CPSCourse-TUM-HN/CPS-LabyrinTUM/calibration/live_roi_source.png

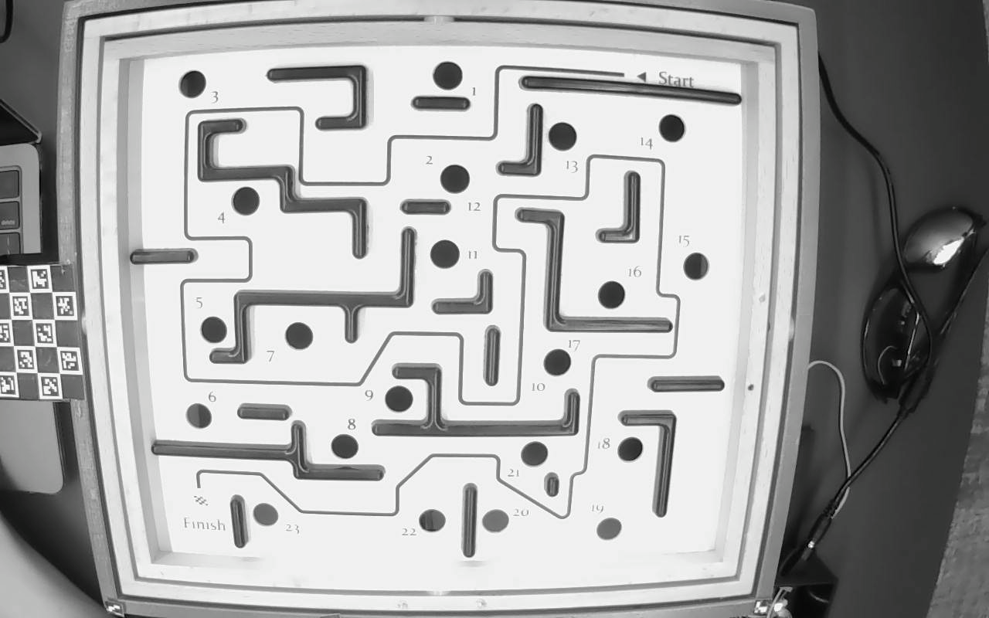
calibration/live_roi_source.png
