CPSCourse-TUM-HN/CPS-LabyrinTUM/docs/video/README.md

# Project Videos

This folder contains the demonstration videos for the CPS LabyrinTUM project.

- `demo.mp4` – Final autonomous marble maze demonstration used for the course presentation.
