CPSCourse-TUM-HN/CPS-LabyrinTUM/(commit log)

2026-06-27 Add keyboard teleop script for manual servo control
    - scripts/keyboard_teleop.py: arrow-key teleop that streams commands
    continuously to hold tilt against the firmware watchdog; supports
    --limit, --step, --invert-yaw/pitch, --swap-axes, --port
    - README: document teleop usage and per-machine serial port note
    - configs/default.yaml: set serial port to COM10 for this bench
    - .gitignore: ignore *.egg-info/ build artifacts
    [default.yaml]
2026-06-27 Add touchpad teleop, launcher UI, and low-latency firmware/serial upgrades
    - Add scripts/touchpad_teleop.py: FPS mouse-warp joystick control via trackpad
    - Add scripts/launcher.py: Tkinter UI to choose keyboard or touchpad mode
    - Rewrite keyboard_teleop.py: pynput multi-key, acceleration model, diagonal support
    - Firmware: 500kbaud, 400kHz I2C, non-blocking serial reader, 200Hz servo updates
    - Remove OK SET echo from firmware to cut per-command serial overhead
    - Bump Python command rate to 200Hz, add pynput dependency
    [default.yaml, maze_servo_controller.ino]
2026-07-06 Add calibration, annotation, axis-mapping, and auto-trace tools
    - calibrate_homography.py: click-4-corners board homography with live
    grid verification; Homography gains inverse (mm->px) transforms
    - annotate_path.py / auto_detect_holes.py / auto_trace_path.py: manual
    path clicking, threshold-based hole detection, and printed-line
    auto-tracing on the rectified board view
    - axis_check.py + control/axis_map.py: measure which servo channel
    drives which board axis (with per-pulse amplitude escalation) and
    save the board->servo mapping for the control loop
    - run_autonomous.py: dry-run mode, live overlay, axis-map integration,
    goal/lost-ball stop conditions, CLI gain/port overrides
    - c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
    [maze_holes.csv, maze_path_auto.csv]
2026-07-06 Make warp tools frame-agnostic for ChArUco homographies
    warp_topdown assumed the board frame spanned (0,0)..(width,height) with
    y down; the ChArUco frame is anchored off-board with y up, so the
    rectified view rendered almost entirely outside the camera image
    (black). The warp now auto-fits its extent to wherever the camera view
    lands in board coordinates and returns (origin, scale), and all px<->mm
    conversions in auto_detect_holes / auto_trace_path use them. Works with
    both corner-click and ChArUco calibrations; maze width/height config no
    longer needed by these tools.
2026-07-06 NOT FUNCTIONAL Homography Add camera intrinsics handling and calibration scripts
    - Introduced CameraIntrinsics class for managing camera parameters.
    - Added scripts for calibrating camera intrinsics and inspecting CharUco homography.
    - Updated README with useful scripts and corrected maze dimensions in config.
    - Implemented undistortion functionality in calibration scripts.
    - Added tests for camera intrinsics round-trip and undistortion identity.
    [default.yaml]
2026-07-09 Wire the pipeline ball tracker into the live tools
    The bright-blob detector fails on this board (holes read like the
    ball), which blocked axis_check. The motion + specular tracker from
    scripts/pipeline.py is streaming-safe by design, so:
    - extract its detection core into cps_maze/vision/ball_pipeline.py;
    scripts/pipeline.py now imports it (one source of truth, CLI behavior
    unchanged; highlight threshold now follows min_specular consistently)
    - add PipelineBallTracker: live adapter with auto-seed/re-seed that
    returns BallDetection, plus optional confusers/ROI JSON loading
    - axis_check and run_autonomous select the tracker via vision.tracker
    config ("pipeline" default, "bright_blob" f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
    [default.yaml]
2026-07-09 Add appearance-template tracking assist and per-machine config overrides
    - config.py: deep-merge configs/local.yaml (gitignored) over the base
    config, so serial port and camera index stop ping-ponging between
    teammates' machines in default.yaml
    - PipelineBallTracker: clicking the ball now also captures a small
    grayscale template; every frame it is correlated near the track and
    overrides lost/predicted states and false locks. Brightness is a
    coin-flip against glare on the white board; appearance is specific
    to the ball. Verified: weak-glint ball (peak below the specular
    gate) tracked 45/45 frames moving + stationary, glare never captures
    the track.
2026-07-09 Add tuning roadmap with commands and per-stage success criteria
2026-07-09 Enhance ball tracking configuration and error handling
    - Updated default.yaml to refine tracking parameters, including min_specular and added new settings for auto-seeding and jump constraints.
    - Modified maze_holes.csv and maze_path_auto.csv to adjust hole positions and path coordinates for improved tracking accuracy.
    - Introduced BallMeasurementError in axis_check.py to provide clearer error messages when the tracker fails to detect the ball.
    - Enhanced measure_ball_mm function to include a timeout for frame detection.
    - Updated PipelineBallTracker and BallTracker classes to incorporate new parameters for better tracking performance and error handling.
    These changes aim to improve the rob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
    [maze_holes.csv, maze_path_auto.csv]
2026-07-10 Correct paper docs: ChArUco calibration was abandoned, not an alternative
2026-07-10 Show board frame and mm cursor readout in the tracking debugger
2026-07-10 Give braking full tilt authority; speed-scale the hole horizon
    Field finding: lowering cruise speed changed nothing and the ball kept
    running into holes. Root cause: the ball's speed comes from gravity on
    the tilted board, and the braking response was throttled twice - the
    0.45 max_command cap (only 45% of the safe firmware tilt range) and the
    3.0/s driving slew (300 ms just to reverse the command; 60 mm of travel
    at 200 mm/s). The knobs were never the binding constraint; authority
    was.
    - brake_max_command (1.0): commands opposing the current motion are
    brakes and may use the full firmware range; driving stays capped at
    max_command for gentleness. Applied in the followers and in the
    r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
    [default.yaml]
2026-07-10 Update calibration and configuration files; enhance ROI handling
    - Updated `default.yaml` to include a new `roi_file` parameter for overriding embedded ROI in confusers.
    - Modified `maze_holes.csv` and `maze_path_auto.csv` to adjust maze configurations.
    - Enhanced `axis_check.py` to support a new mapping mode for axis response normalization.
    - Added functionality in `recalibrate_all.py` and `select_maze_roi.py` to capture and save ROI photos.
    - Introduced a new method in `ball_pipeline.py` to load ROI from a JSON file, allowing for dynamic ROI updates.
    - Updated tests to validate the new ROI handling and configuration changes.
    [maze_holes.csv, maze_path_auto.csv]
2026-07-11 Add wall escape functionality and refine hole hazard handling
    Introduced new parameters in `default.yaml` for wall escape behavior, including `wall_escape_distance_mm`, `wall_escape_speed_mm_s`, `wall_escape_command`, and `wall_escape_min_command`. Updated `run_autonomous.py` to utilize these parameters for improved ball navigation near walls, preventing stalling. Enhanced `path_hazard_distance_mm` in `hazards.py` to allow ignoring current hazards, and added tests to validate the new behavior. Updated visualizations in `visualize_run.py` to display wall escape commands. 46 tests pass, ensuring robust performance in complex environments.
    [default.yaml]
2026-07-11 Update calibration images, enhance configuration parameters, and improve logging functionality
    - Replaced `live_roi_overlay.png` and `live_roi_source.png` with updated versions.
    - Modified `default.yaml` to increase `max_command` and `brake_max_command` values for improved control responsiveness.
    - Updated `maze_holes.csv` and `maze_path_auto.csv` with new maze configurations.
    - Introduced `RUN_LOG_FIELDS` in `run_autonomous.py` for enhanced logging of autonomous run data.
    - Added tests to validate the new logging functionality and ensure proper handling of hole-related data.
    [maze_holes.csv, maze_path_auto.csv]
2026-07-11 Make axis_check fail safe: never clobber the working map, no raw crashes
    The axis map is now treated as a fixed calibrated artifact
    (calibration/axis_map.npz) that the runner loads; axis_check is only
    the re-measurement tool. Three failure modes hardened:
    - a degenerate measured response printed a raw ValueError traceback;
    it now explains the problem and exits WITHOUT touching the existing
    map
    - a successful but bad rerun would silently overwrite the working
    fixed map; the previous file is now backed up with a timestamp and
    restore instructions are printed
    - camera/serial being held by another tool raised raw exceptions; both
    are probed up front with clear close-the-other-tool mes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
2026-07-11 Record a ball-free video for confuser calibration in recalibrate_all
    Run forensics on tonight's log (62% reached, then chaos): the
    orchestrator rebuilds confusers from its tracking-validation recording,
    which by design has the ball being driven around - so the ball
    blacklists its own resting spots again (90 ghost confusers tonight),
    while the board's one genuinely static glint fixture stayed UNCOVERED.
    Result: 20% detection loss, 55-81mm tracking teleports onto the
    uncovered glint, association jumps (703->0), and thrashing stalls at
    full command.
    recalibrate_all now records a separate 20s BALL-FREE clip for the
    confuser step (with an explicit remove-the-ball prompt) and keeps the
    ball video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
2026-07-11 Document and expose the stabilize (composure) tuning knobs
    [default.yaml]
2026-07-11 Add camera FPS/format probe: the 10Hz control loop is the real problem
    The autonomous run's control loop measured 10.6 Hz (94 ms/iteration) while
    tracker+draw+serial cost under 10 ms combined. The missing ~85 ms is
    VideoCapture.read() blocking: the camera only DELIVERS ~10 fps, not the 120
    it can do. At 10 Hz the controller is always ~150 ms behind a marble that
    crosses 9 mm per frame, so it over-corrects and the ball rings - that is the
    'can't stabilize' behavior, and no control-gain tuning can fix an
    undersampled loop.
    This probe opens the camera like the runner, measures the REAL delivered fps,
    reports the negotiated format + exposure, and tries MJPG/resolution alternates
    so the lab run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
2026-07-12 Refine recovery A* path planning and enhance control parameters
    - Updated `default.yaml` to further optimize control parameters, including adjustments to `min_speed_frac` and `corner_slow_deg`.
    - Improved recovery A* path planning logic in `run_autonomous.py` to better assist the ball in off-route situations, with enhanced wall and hole clearance parameters.
    - Enhanced responsiveness and safety during autonomous runs by refining recovery scenario handling based on ball position and speed.
    - Ensured compatibility with existing control mechanisms while boosting overall navigation robustness.
2026-07-12 Add camera server: open the camera once, share frames to every script
    MSMF opens the camera at 120fps but takes 10-30 s to open, which is painful
    to pay per script across a calibration/lab session. New scripts/camera_server.py
    opens the device once and publishes the latest frame into shared memory;
    CameraCapture.open() auto-attaches to it (instant) when it is running and
    falls through to opening the device directly when it is not - no per-script
    changes needed. Disable with camera.use_shared_server=false or
    CPS_CAMERA_NO_SERVER=1.
    Bonus: each shared frame carries the server's true monotonic capture time, so
    distinct frames always have their real ~8-16 ms spacing even when a client
    reads the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
2026-07-12 Stop the wall mask from parking the ball at the start
    The ball sat at the start for 91 s, creeping at 3 mm/s while the controller
    only aimed for ~5 mm/s there. Cause: the runtime wall speed-scale was 0.35 for
    99% of the run because the regenerated wall mask (57% of cells marked wall) put
    the on-route start ~4 mm from a wall. speed_scale = min(wall_scale, profile)
    let that 0.35 override the profile's 0.6 and throttle the on-route target to a
    crawl the ball never escaped - an invisible speed wall.
    The runtime wall scale was always meant as OFF-route protection (its own
    comment says so, and the speed profile already handles planned wall clearance
    on-route). Apply it only once the ball drifts p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
    [default.yaml]
2026-07-12 axis_check: warn when a direction moved far less (ball hit a wall)
    A -pitch pulse that read 36 mm vs ~80 mm for the other three directions
    silently skewed the axis map: the map treated pitch as weak and boosted it
    26%, which over-drove pitch and produced a ~15 Hz wiggle that trapped the ball
    at the start (the shake stayed just above the stall threshold, so the
    break-free kick never fired). The cause was the ball hitting a wall mid-pulse.
    axis_check now prints each direction's response magnitude and warns when any
    is <60% of the median, telling the operator to re-run with the ball in open
    space before saving.
2026-07-12 Disable A* recovery: false wall triggers from the oblique wall view
    The camera's oblique view of the walls is imperfect, so the ball frequently
    looks like it is touching a wall when it is not. That fired constant
    'A* recovery: wall' episodes that hijacked the carrot and made the ball worse.
    Disable the recovery planner by default; normal path following, the off-route
    wall speed-scale, and the emergency brake still cover recovery. Re-enable when
    the wall mask/view is cleaner.
2026-07-12 Paper: document this session's struggles and correct the camera facts
    struggles.md: add the camera frame-rate discovery (10fps DirectShow ->
    120fps MSMF), the camera server, phantom velocities from burst frames, the
    10Hz-loop misdiagnosis, the wall mask parking the ball, the composure state,
    false wall contacts from the oblique view, and backlash masquerading as a weak
    axis; extend the 'debug by measurement' lesson to tie them together. Correct
    the old DirectShow+MJPG claim (MJPG was never accepted by this camera).
    software_setup.md: update the camera-backend and velocity-estimation facts to
    match (MSMF + camera server, estimator guards), note the off-route-only wall
    slowdown and the compos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
2026-07-12 Fix command spikes: slew-limit burst frames, hold kick tilt when stalled
    Two reasons the servo commands changed faster than the servos can follow
    (spiking to ~0.5-0.7 for a single frame then collapsing, so the board twitched
    instead of tilting and the ball barely moved):
    1. The slew limiter was gated on dt_s > 0, so on MSMF burst/duplicate frames
    (dt=0, ~15% of frames) it was skipped entirely and the full un-slewed
    command went straight to the servo AND poisoned prev_servo_cmd. Now a dt=0
    frame holds the previous command - no time elapsed, so the command cannot
    legitimately change.
    2. slew_limit_command fast-collapsed ANY reducing command, so a breakaway kick
    tilt dropped aw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
2026-07-12 Cap the stall kick so a breakaway can't fling the ball into a hole
    Root cause of the fall into hole 4: the ball stalled ~28 mm before a
    hole-adjacent section, and the stall-kick ramp is unbounded (0.30 + 0.25/s),
    so after a ~5 s stall it reached ~0.97. When the ball finally broke free it
    launched at 50-70 mm/s straight toward hole idx15 (physical hole 4); the
    emergency brake fired but cannot stop a 67 mm/s ball 1.6 mm from the hole, so
    it fell in.
    Cap the ramped kick with stall_kick_max (default 0.7): high enough to beat
    stiction at most spots (breakaway ~0.4), low enough that a breakaway does not
    overshoot into an adjacent hole. Trade-off: a very stubborn spot may need a
    manual nudge, whic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
    [default.yaml]
2026-07-12 Make the driving tilt actually move the ball; restore full kick authority
    The ball only ever moved on the stall-kick because the driving tilt was far
    too weak: k_vel=0.012 gives 0.012*15 = 0.18, well below the ~0.4-1.0 tilt this
    (high-stiction) ball needs to break free, so pitch/yaw did nothing and the kick
    did all the work in bursts. And the 0.7 kick cap starved the stubborn spots
    that need up to full tilt, so it wouldn't move at all.
    - k_vel 0.012 -> 0.04: driving tilt reaches ~0.6 when stalled, so the actual
    velocity control drives the ball (and brakes harder when overspeeding).
    - stall_kick 0.30 -> 0.45: breakaway push starts closer to what the ball needs,
    less ramp waiting.
    - stall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
    [default.yaml]
2026-07-12 Add displacement-based unstick to escape tight corners
    The ball got stuck at the first corner (96% of a run jittering at one spot).
    Root cause: it twitches to ~10 mm/s IN PLACE, and the velocity-based stall kick
    reads that as 'moving' and resets before it can ramp - velocity cannot tell
    twitching-in-place from slow rolling, so the kick never builds the sustained
    push a corner needs. Raising the kick cap does not help because the kick never
    reaches the cap; it resets first.
    New unstick: track the ball's ACTUAL net displacement over a ~1 s window; if it
    has moved less than unstick_dist_mm while the plan wants motion, ramp a
    sustained push toward the carrot (unstick_base .. unstick_max) until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
    [default.yaml]
2026-07-13 Velocity PI control: perfect-speed regime, retire the stick/kick hacks
    Rethink of the movement. The ball is a stiction plant (tilt -> acceleration).
    The carrot follower used pure-P velocity control, which commands ZERO tilt at
    zero speed error - so the ball stalls, static friction pins it, and every hack
    (discrete stall kick, displacement unstick, stabilize) was a patch for the
    missing integral, each introducing the launch/overshoot/thrash it was meant to
    fix.
    Replace with a proper velocity PI whose INTEGRAL is the friction/stiction
    compensator: it ramps the tilt up smoothly until the ball breaks free, holds a
    nonzero tilt at steady state to maintain speed against friction, and unwinds as
    t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
    [default.yaml]
2026-07-13 Startup danger check: warn + crawl the plan through hole-at-a-corner passes
    Analysis of the (good) PI run that fell at hole 4: the ball overspeeds the plan
    (ran 22, spiked to 67 mm/s vs a 15 target) and, at hole 4's 61-deg U-turn,
    can't make the corner and is flung into the hole in the crook. The route on
    this dense board passes within the ball's wobble range of 16 of ~23 holes, so
    proximity alone can't isolate the risk - but proximity AND a sharp turn does.
    route_hole_proximity() (pure, tested): at startup, flag a hole only when the
    route's closest approach clears its capture zone by < hole_danger_margin_mm AND
    the route turns >= hole_danger_turn_deg there. On this route that is exactly 3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
    [default.yaml]
2026-07-13 Danger check: also crawl holes the route grazes (not just sharp turns)
    Two full-map runs (0-5, 5-23) completed the maze but fell at holes the
    turn-gate check missed: hole 5 (idx11) fell at 210 mm/s on a STRAIGHT (turn 0),
    and idx3 fell near the finish - both holes the route nearly grazes (~+1 mm
    clear). At that clearance any overspeed drops the ball in, turn or not.
    Add a second flag reason to route_hole_proximity:
    - touch: route clears the capture zone by < touch_mm (2.5) -> crawl regardless
    of turn.
    - corner: close AND a sharp turn (unchanged, hole 4's U-turn).
    On the real route this flags 7 spots incl. hole 5 and idx3 (was 3). Also add
    an explicit hole_danger_indices config override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
    [default.yaml]
2026-07-13 Wall-hug detour: route the ball around hole 5 along the wall
    Hole 5 (idx11) sits on the RIGHT of a downhill descent with >24 mm of open
    space on the LEFT; three runs all fell right into it. Rather than only crawl
    past it, route AROUND it: a configurable lateral-offset zone shifts the carrot
    perpendicular to the path (along the left-normal) so the ball hugs the wall and
    rejoins the path before the next hole.
    lateral_offset_at() (pure, tested) gives a ramped offset per zone so the ball
    eases onto and off the off-centerline line. The runner shifts the carrot by
    offset * left_normal. Configured zone for hole 5 (prog 355-393, +10 mm, 8 mm
    ramp): verified the shifted target runs 23-25 mm from the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
2026-07-13 Wall-hug detour up and away from hole 23 near the finish
2026-07-13 Add wall lean functionality to enhance control near holes
    - Updated `default.yaml` to include new wall lean zones for better ball stability near holes 22 and 23.
    - Modified `run_autonomous.py` to implement wall lean commands, allowing for a one-sided damped bias along the path normal.
    - Enhanced `visualize_run.py` to visualize wall lean commands during runs, providing better insight into ball behavior near walls.
    This update aims to improve the ball's trajectory and reduce the likelihood of overshooting into holes by leaning against the wall effectively.
    [default.yaml]
